Centomz/ppg-esp32/(commit log)

2026-11-02 Stage 2: sampling check
    [ppg_raw.csv]
2026-11-02 Stage 3: band-pass filter
2026-11-03 Update scripts, add rest and exercise recordings
    [ppg_raw_exercice.csv, ppg_raw_rest.csv]
